gregdavill/ArcticKoala/hw/ArcticKoala-r0.1/plot/render_002.jpg

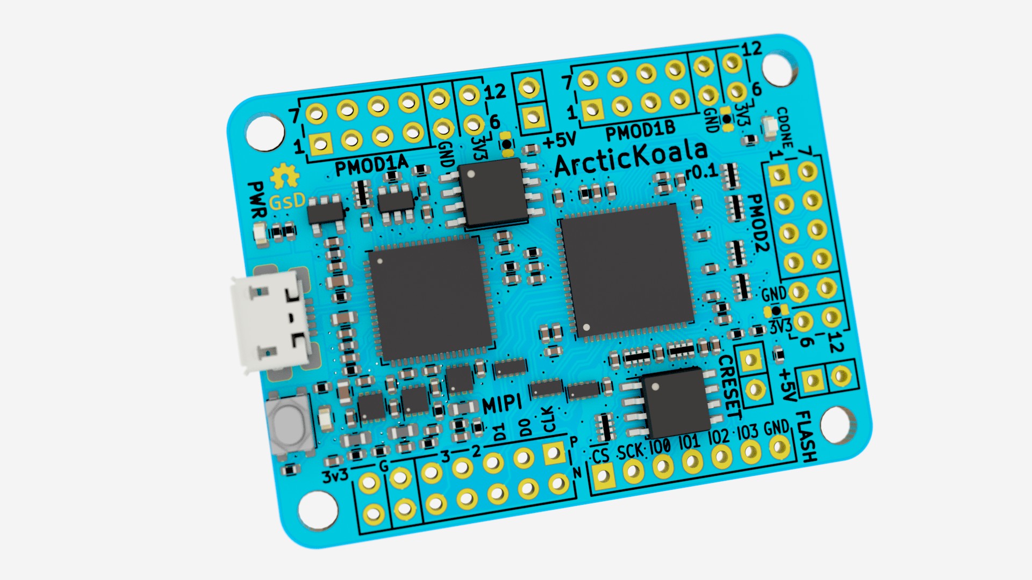
hw/ArcticKoala-r0.1/plot/render_002.jpg
