gregdavill/ArcticKoala/hw/ArcticKoala-r0.1/plot/arctic-koala-Back.png

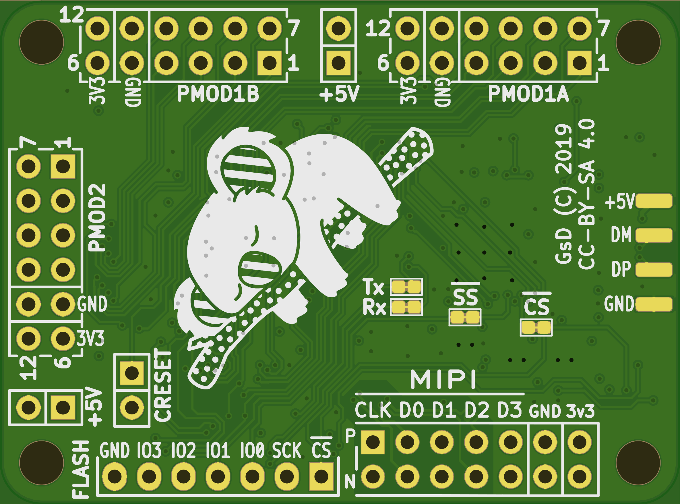
hw/ArcticKoala-r0.1/plot/arctic-koala-Back.png
