gregdavill/ArcticKoala/hw/ArcticKoala-r0.1/plot/arctic-koala-Front.png

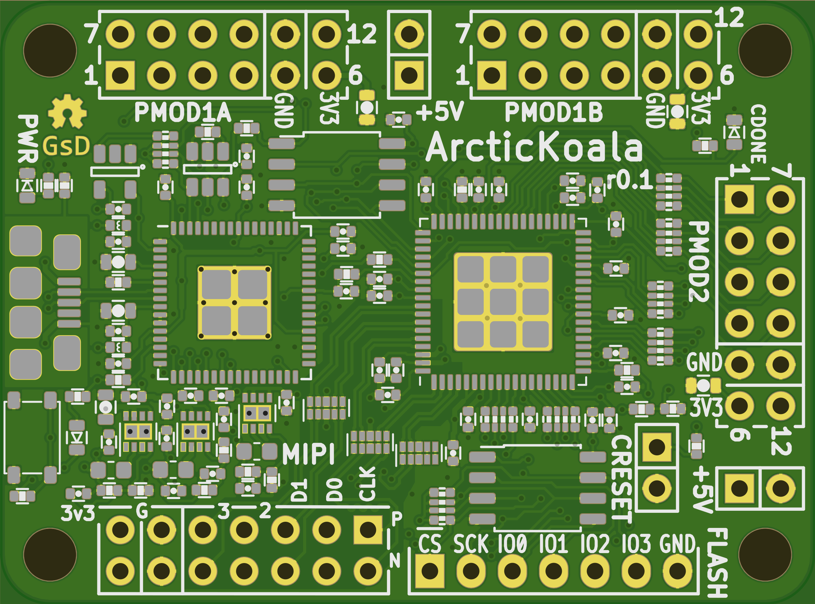
hw/ArcticKoala-r0.1/plot/arctic-koala-Front.png
