gregdavill/ArcticKoala/(threads)

Thread 1 (2019-12-13):

It needs more external memory

tommythorn, 2019-12-13:
It had to be said :)

gregdavill, 2019-12-15:
64Mbit isn't enough? :(

gregdavill, 2019-12-15:
Also, for what it's worth. The QFN72 package does not have the I/O resources to drive any form of DDR2/3/4 memory. That only appears to be available in the BGA packages.

tommythorn, 2019-12-15:
It’s your board, your rules.  I’m just here to speak up for the memory pigs.  Given the purpose of this board, SPI is probably ideal (way easier to use), but you are not going to drive video or run desktop Linux with this.

Closed 2019-12-15.

Thread 2 (2019-12-21):

PSRAM has wrong footprint

gregdavill, 2019-12-21:
PSRAM is available in standard SOIC8 packages, the hardware is populated with a Wide SOIC8 footprint.
The RAM still fits well enough.

Severity: minor.

Thread 3 (2019-12-21):

Red user LED is dim when FPGA is un-configured.

gregdavill, 2019-12-21:
- The FPGA applies a weak pull-up to all un-configured pins.
- The user LED is connected to a 1v8 I/O designed to be activated in an open-drain configuration.
- The Anode of the LED is connected to 3v3.

These design choices result in the LED activating from the ~1.5V that is applied across it and the current drawn from the weak-pull ups. Because LEDs are so efficient the LED appears around 50% brightness in this condition.

Thread 4 (2019-12-21):

FTDI contends the SPI bus with the FPGA

gregdavill, 2019-12-21:
While IDLE the FTDI appears to drive the bus reasonably hard. Enough to result in signals only making it to around 1/2 Vcc when driven by the FPGA. Because the FTDI is a second master connected to the FLASH for programming. This results in the configuration not being correctly loaded by the FPGA.

Adding 100R resistance inline to the following signals is enough to weaken the FTDIs grasp.
- SCK
- MISO
- MOSI
- CS

Thread 5 (2020-01-02):

Resistors on HighSpeed banks

gregdavill, 2020-01-02:
In-line resistors on high speed banks leading to the PMODs prohibit use of these pins for ~gigabit speed signals.

Solutions:
 - Add parallel inline capacitor as a high speed bypass. (May require downstream bias resistors depending on I/O standard)
 - Replace 33R with 0R
