gregdavill/ArcticKoala/hw/ArcticKoala-r0.1/arctic-koala.kicad_pcb

## KiCad design hw/ArcticKoala-r0.1/arctic-koala.kicad_pcb (2020-10-22)

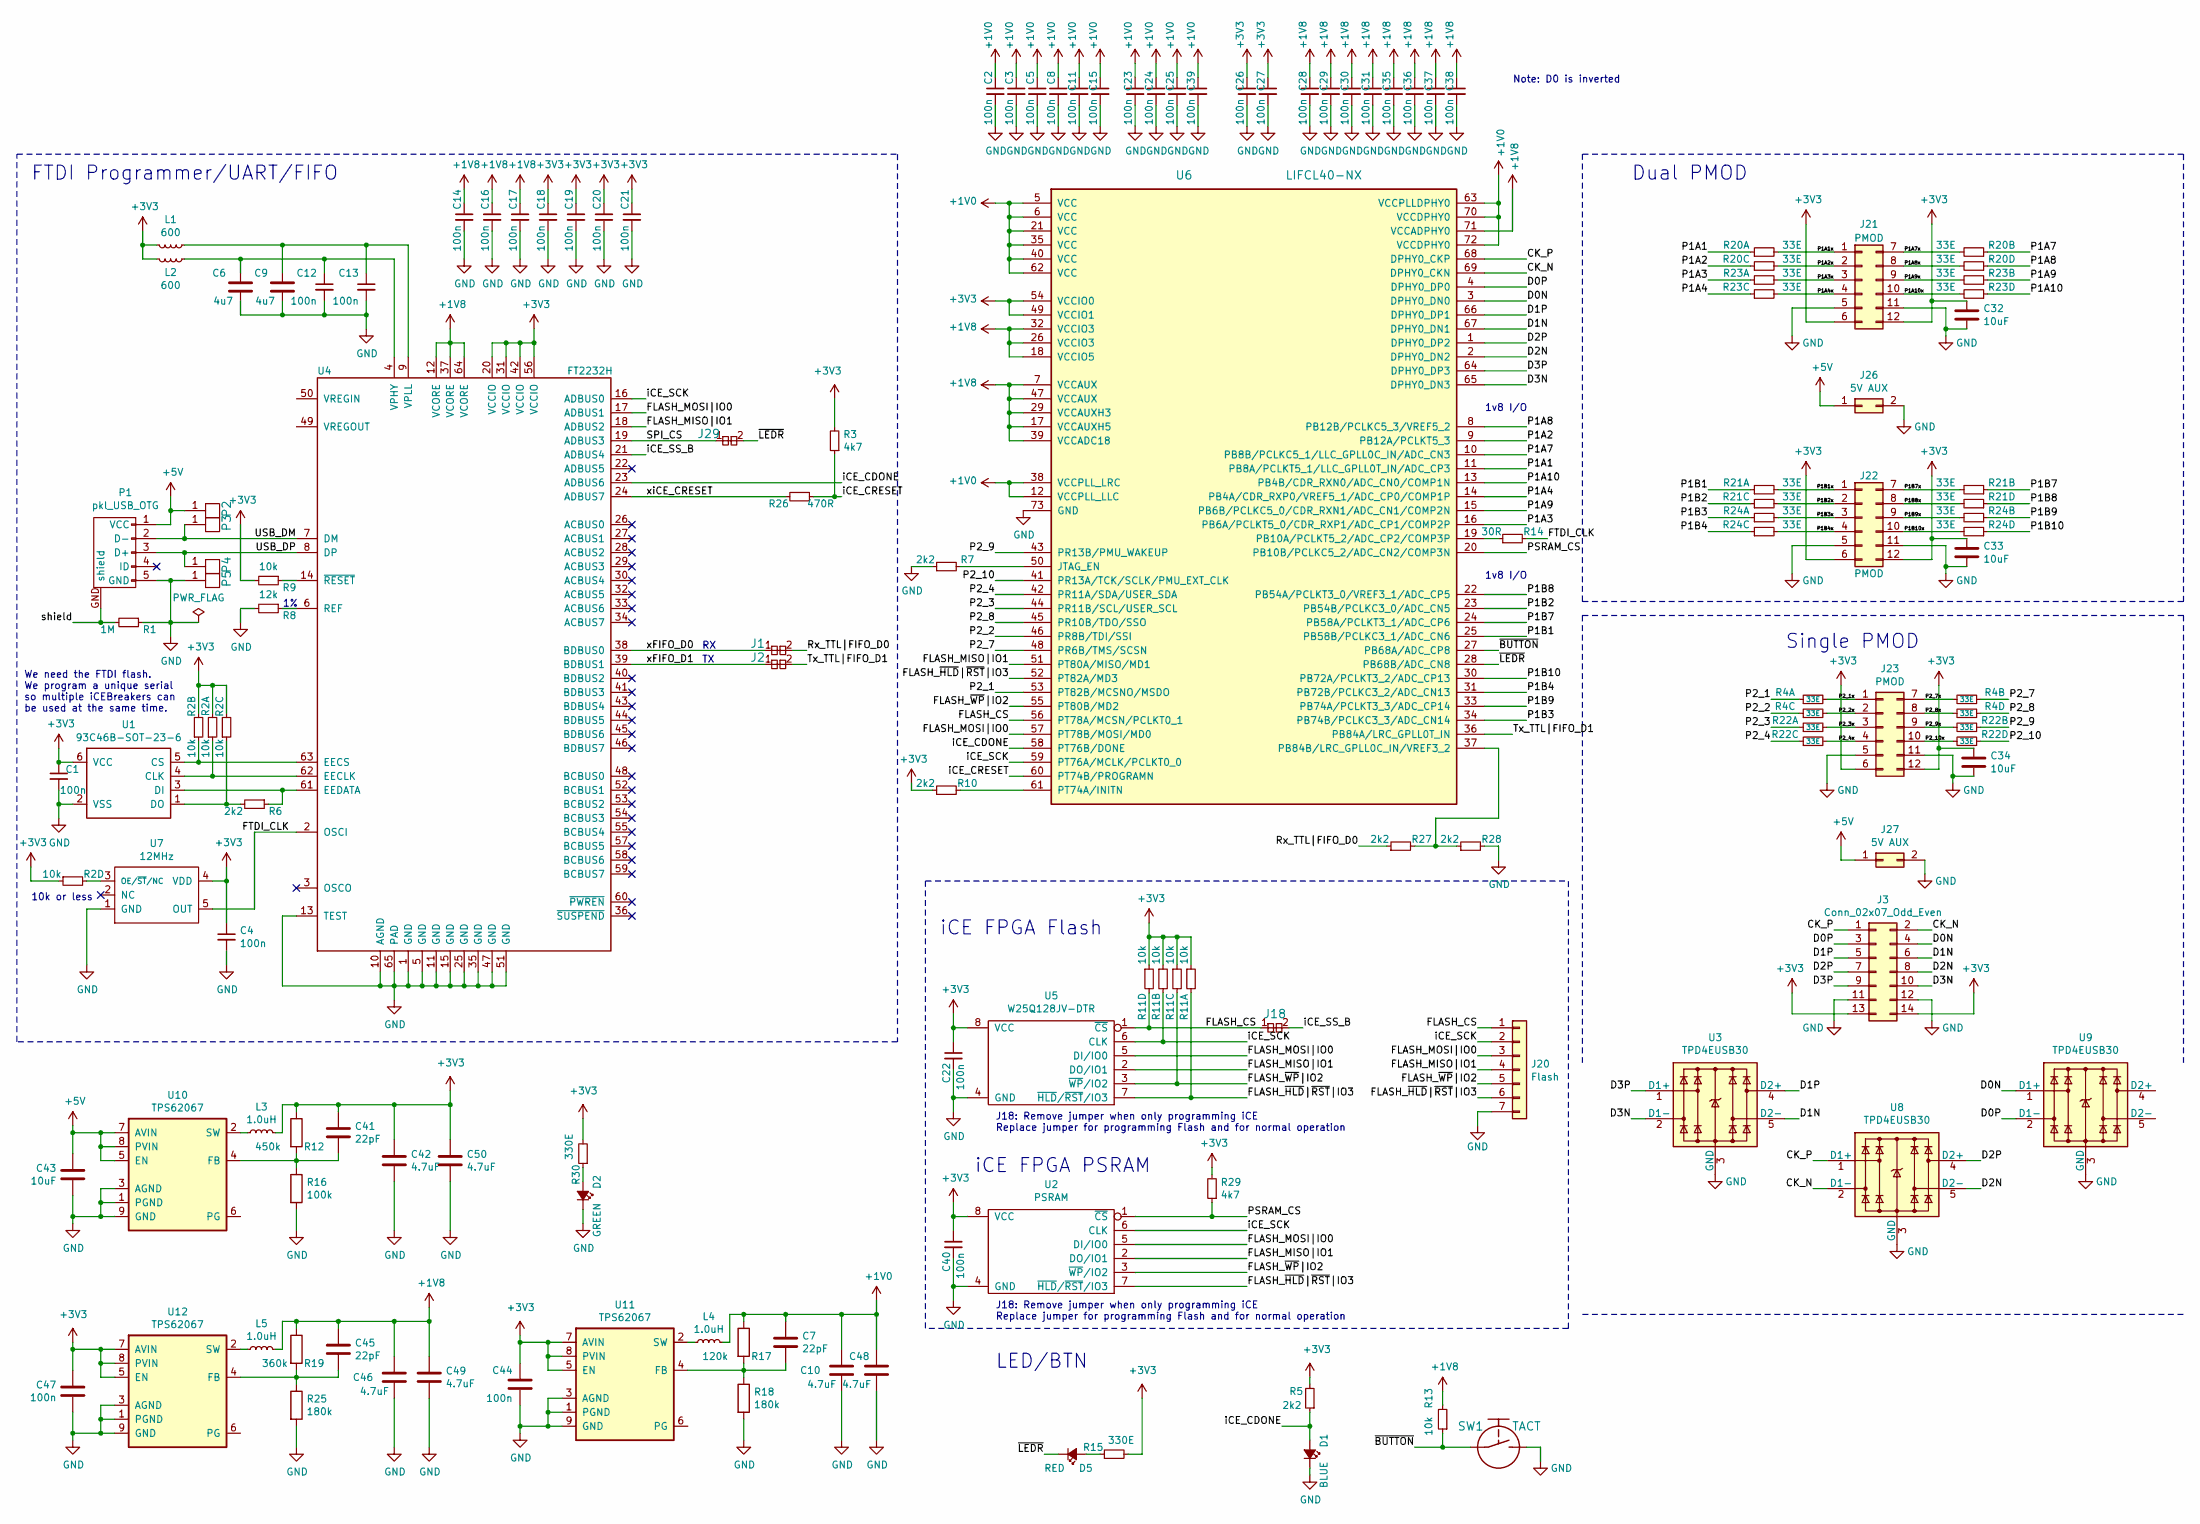
[picture p5: schematic arctic-koala.sch, ArcticKoala]

Parts:
C1, C2, C3, C4, C5, C8, C11, C12, C13, C14, C15, C16, C17, C18, C19, C20, C21, C22, C23, C24, C25, C26, C27, C28, C29, C30, C31, C35, C36, C37, C38, C39, C40, C44, C47: 100n; C_0402
C6, C9: 4u7; C_0603
C7, C41, C45: 22pF; C_0402
C10, C42, C46, C48, C49, C50: 4.7uF; C_0402
C32, C33, C34, C43: 10uF; C_0603
D1: BLUE; D_0603
D2: GREEN; D_0603
D5: RED; D_0603
J1, J2, J18, J29: Jumper; J_NC_0603_15
J3: Conn_02x07_Odd_Even; PinSocket_2x07_P2.54mm_Vertical
J20: Flash; Pin_Header_Straight_1x07
J21, J22, J23: PMOD; Socket_Strip_Angled_2x06
J26, J27: 5V AUX; Pin_Header_Straight_2x01
L1, L2: 600; L_0402
L3, L4, L5: 1.0uH; L_0603_1608Metric
P1: pkl_USB_OTG; Connector_USB_Micro_B_SMD
P2, P3, P4, P5: UP; PAD_SMD_1x2.65
R1: 1M; R_0402
R2, R11: 10k; R_Array_Convex_4x0402
R3, R29: 4k7; R_0402
R4, R20, R21, R22, R23, R24: 33E; R_Array_Convex_4x0402
R5, R6, R7, R10, R27, R28: 2k2; R_0402
R8: 12k; R_0402
R9, R13: 10k; R_0402
R12: 450k; R_0402
R14: 30R; R_0402
R15, R30: 330E; R_0402
R16: 100k; R_0402
R17: 120k; R_0402
R18, R25: 180k; R_0402
R19: 360k; R_0402
R26: 470R; R_0402
SW1: TACT; SW_SPST_3x4x2.5
U1: 93C46B-SOT-23-6; SOT-23-6
U2: PSRAM; SOIC-8_5.3x5.3mm_Pitch1.27mm
U3, U8, U9: TPD4EUSB30; USON-10_2.5x1.0mm_P0.5mm
U4: FT2232H; QFN-64-4.45mm1EP_9x9mm_Pitch0.5mm
U5: W25Q128JV-DTR; SOIC-8_5.3x5.3mm_Pitch1.27mm
U6: LIFCL40-NX; QFN-72-1EP_10x10mm_P0.5mm_EP6x6mm
U7: 12MHz; SOT-23-5
U10, U11, U12: TPS62067; WSON-8-1EP_2x2mm_P0.5mm_EP0.9x1.6mm_ThermalVias

Connections:
+1V0: C2.1, C3.1, C5.1, C7.1, C8.1, C10.1, C11.1, C15.1, C23.1, C24.1, C25.1, C39.1, C48.1, L4.2, R17.1, U6.5 (VCC), U6.6 (VCC), U6.12 (VCCPLL_LLC), U6.21 (VCC), U6.35 (VCC), U6.38 (VCCPLL_LRC), U6.40 (VCC), U6.62 (VCC), U6.63 (VCCPLLDPHY0), U6.70 (VCCDPHY0), U6.72 (VCCDPHY0)
+1V8: C14.1, C16.1, C17.1, C28.1, C29.1, C30.1, C31.1, C35.1, C36.1, C37.1, C38.1, C45.1, C46.1, C49.1, L5.2, R13.2, R19.1, U4.12 (VCORE), U4.37 (VCORE), U4.64 (VCORE), U6.7 (VCCAUX), U6.17 (VCCAUXH5), U6.18 (VCCIO5), U6.26 (VCCIO3), U6.29 (VCCAUXH3), U6.32 (VCCIO3), U6.39 (VCCADC18), U6.47 (VCCAUX), U6.71 (VCCADPHY0)
+3V3: C1.1, C4.1, C18.1, C19.1, C20.1, C21.1, C22.1, C26.1, C27.1, C32.2, C33.2, C34.2, C40.1, C41.1, C42.1, C44.1, C47.1, C50.1, J3.13, J3.14, J21.6, J21.12, J22.6, J22.12, J23.6, J23.12, L1.1, L2.1, L3.2, R2.2, R2.4, R2.6, R2.7, R3.2, R5.2, R9.2, R10.1, R11.1, R11.3, R11.5, R11.7, R12.1, R15.2, R29.2, R30.2, U1.6 (VCC), U2.8 (VCC), U4.20 (VCCIO), U4.31 (VCCIO), U4.42 (VCCIO), U4.56 (VCCIO), U5.8 (VCC), U6.49 (VCCIO1), U6.54 (VCCIO0), U7.4 (VDD), U11.5 (EN), U11.7 (AVIN), U11.8 (PVIN), U12.5 (EN), U12.7 (AVIN), U12.8 (PVIN)
+5V: C43.1, J26.1, J27.1, P1.1 (VCC), P2.1, U10.5 (EN), U10.7 (AVIN), U10.8 (PVIN)
/CK_N: J3.2, U6.69 (DPHY0_CKN), U8.2 (D1-)
/CK_P: J3.1, U6.68 (DPHY0_CKP), U8.1 (D1+)
/D0N: J3.4, U6.3 (DPHY0_DN0), U9.1 (D1+)
/D0P: J3.3, U6.4 (DPHY0_DP0), U9.2 (D1-)
/D1N: J3.6, U3.5 (D2-), U6.67 (DPHY0_DN1)
/D1P: J3.5, U3.4 (D2+), U6.66 (DPHY0_DP1)
/D2N: J3.8, U6.2 (DPHY0_DN2), U8.5 (D2-)
/D2P: J3.7, U6.1 (DPHY0_DP2), U8.4 (D2+)
/D3N: J3.10, U3.2 (D1-), U6.65 (DPHY0_DN3)
/D3P: J3.9, U3.1 (D1+), U6.64 (DPHY0_DP3)
/FLASH_CS: J18.1, J20.1, R11.8, U5.1 (~CS), U6.56 (PT78A/MCSN/PCLKT0_1)
/FLASH_MISO|IO1: J20.4, U2.2 (DO/IO1), U4.18 (ADBUS2), U5.2 (DO/IO1), U6.51 (PT80A/MISO/MD1)
/FLASH_MOSI|IO0: J20.3, U2.5 (DI/IO0), U4.17 (ADBUS1), U5.5 (DI/IO0), U6.57 (PT78B/MOSI/MD0)
/FLASH_~HLD~|~RST~|IO3: J20.6, R11.2, U2.7 (~HLD~/~RST~/IO3), U5.7 (~HLD~/~RST~/IO3), U6.52 (PT82A/MD3)
/FLASH_~WP~|IO2: J20.5, R11.6, U2.3 (~WP~/IO2), U5.3 (~WP~/IO2), U6.55 (PT80B/MD2)
/FTDI_CLK: R14.2, U4.2 (OSCI), U7.5 (OUT)
/P1A1: R20.1, U6.11 (PB8A/PCLKT5_1/LLC_GPLL0T_IN/ADC_CP3)
/P1A1x: J21.1, R20.2
/P1A2: R20.5, U6.9 (PB12A/PCLKT5_3)
/P1A2x: J21.2, R20.6
/P1A3: R23.1, U6.16 (PB6A/PCLKT5_0/CDR_RXP1/ADC_CP1/COMP2P)
/P1A3x: J21.3, R23.2
/P1A4: R23.5, U6.14 (PB4A/CDR_RXP0/VREF5_1/ADC_CP0/COMP1P)
/P1A4x: J21.4, R23.6
/P1A7: R20.3, U6.10 (PB8B/PCLKC5_1/LLC_GPLL0C_IN/ADC_CN3)
/P1A7x: J21.7, R20.4
/P1A8: R20.7, U6.8 (PB12B/PCLKC5_3/VREF5_2)
/P1A8x: J21.8, R20.8
/P1A9: R23.3, U6.15 (PB6B/PCLKC5_0/CDR_RXN1/ADC_CN1/COMP2N)
/P1A9x: J21.9, R23.4
/P1A10: R23.7, U6.13 (PB4B/CDR_RXN0/ADC_CN0/COMP1N)
/P1A10x: J21.10, R23.8
/P1B1: R21.1, U6.25 (PB58B/PCLKC3_1/ADC_CN6)
/P1B1x: J22.1, R21.2
/P1B2: R21.5, U6.23 (PB54B/PCLKC3_0/ADC_CN5)
/P1B2x: J22.2, R21.6
/P1B3: R24.1, U6.34 (PB74B/PCLKC3_3/ADC_CN14)
/P1B3x: J22.3, R24.2
/P1B4: R24.5, U6.31 (PB72B/PCLKC3_2/ADC_CN13)
/P1B4x: J22.4, R24.6
/P1B7: R21.3, U6.24 (PB58A/PCLKT3_1/ADC_CP6)
/P1B7x: J22.7, R21.4
/P1B8: R21.7, U6.22 (PB54A/PCLKT3_0/VREF3_1/ADC_CP5)
/P1B8x: J22.8, R21.8
/P1B9: R24.3, U6.33 (PB74A/PCLKT3_3/ADC_CP14)
/P1B9x: J22.9, R24.4
/P1B10: R24.7, U6.30 (PB72A/PCLKT3_2/ADC_CP13)
/P1B10x: J22.10, R24.8
/P2_1: R4.1, U6.53 (PT82B/MCSNO/MSDO)
/P2_1x: J23.1, R4.2
/P2_2: R4.5, U6.46 (PR8B/TDI/SSI)
/P2_2x: J23.2, R4.6
/P2_3: R22.1, U6.44 (PR11B/SCL/USER_SCL)
/P2_3x: J23.3, R22.2
/P2_4: R22.5, U6.42 (PR11A/SDA/USER_SDA)
/P2_4x: J23.4, R22.6
/P2_7: R4.3, U6.48 (PR6B/TMS/SCSN)
/P2_7x: J23.7, R4.4
/P2_8: R4.7, U6.45 (PR10B/TDO/SSO)
/P2_8x: J23.8, R4.8
/P2_9: R22.3, U6.43 (PR13B/PMU_WAKEUP)
/P2_9x: J23.9, R22.4
/P2_10: R22.7, U6.41 (PR13A/TCK/SCLK/PMU_EXT_CLK)
/P2_10x: J23.10, R22.8
/PSRAM_CS: R29.1, U2.1 (~CS), U6.20 (PB10B/PCLKC5_2/ADC_CN2/COMP3N)
/Rx_TTL|FIFO_D0: J1.2, R27.1
/SPI_CS: J29.1, U4.19 (ADBUS3)
/Tx_TTL|FIFO_D1: J2.2, U6.36 (PB84A/LRC_GPLL0T_IN)
/USB_DM: P1.2 (D-), P3.1, U4.7 (DM)
/USB_DP: P1.3 (D+), P4.1, U4.8 (DP)
/iCE_CDONE: D1.A, R5.1, U4.23 (ADBUS6), U6.58 (PT76B/DONE)
/iCE_CRESET: R3.1, R26.1, U6.60 (PT74B/PROGRAMN); also elsewhere on the board
/iCE_SCK: J20.2, R11.4, U2.6 (CLK), U4.16 (ADBUS0), U5.6 (CLK), U6.59 (PT76A/MCLK/PCLKT0_0)
/iCE_SS_B: J18.2, U4.21 (ADBUS4)
/shield: P1.GND (shield), R1.2
/xFIFO_D0: J1.1, U4.38 (BDBUS0)
/xFIFO_D1: J2.1, U4.39 (BDBUS1)
/xiCE_CRESET: R26.2, U4.24 (ADBUS7)
/~BUTTON: R13.1, SW1.1, U6.27 (PB68A/ADC_CP8)
/~LEDR: D5.C, J29.2, U6.28 (PB68B/ADC_CN8)
GND: C1.2, C2.2, C3.2, C4.2, C5.2, C6.2, C8.2, C9.2, C10.2, C11.2, C12.2, C13.2, C14.2, C15.2, C16.2, C17.2, C18.2, C19.2, C20.2, C21.2, C22.2, C23.2, C24.2, C25.2, C26.2, C27.2, C28.2, C29.2, C30.2, C31.2, C32.1, C33.1, C34.1, C35.2, C36.2, C37.2, C38.2, C39.2, C40.2, C42.2, C43.2, C44.2, C46.2, C47.2, C48.2, C49.2, C50.2, D1.C, D2.C, J3.11, J3.12, J20.7, J21.5, J21.11, J22.5, J22.11, J23.5, J23.11, J26.2, J27.2, P1.5 (GND), P5.1, R1.1, R7.1, R8.2, R16.2, R18.2, R25.2, R28.2, SW1.2, U1.2 (VSS), U2.4 (GND), U3.3 (GND), U3.8 (GND), U4.1 (GND), U4.5 (GND), U4.10 (AGND), U4.11 (GND), U4.13 (TEST), U4.15 (GND), U4.25 (GND), U4.35 (GND), U4.47 (GND), U4.51 (GND), U4.65 (PAD), U5.4 (GND), U6.73 (GND), U7.1 (GND), U8.3 (GND), U8.8 (GND), U9.3 (GND), U9.8 (GND), U10.1 (PGND), U10.3 (AGND), U10.9 (GND), U11.1 (PGND), U11.3 (AGND), U11.9 (GND), U12.1 (PGND), U12.3 (AGND), U12.9 (GND); also elsewhere on the board
unnamed: C7.2, R17.2, R18.1, U11.4 (FB)
unnamed: C6.1, C12.1, L2.2, U4.4 (VPHY)
unnamed: C9.1, C13.1, L1.2, U4.9 (VPLL)
unnamed: C41.2, R12.2, R16.1, U10.4 (FB)
unnamed: C45.2, R19.2, R25.1, U12.4 (FB)
unnamed: D2.A, R30.1
unnamed: D5.A, R15.1
unnamed: L3.1, U10.2 (SW)
unnamed: L4.1, U11.2 (SW)
unnamed: L5.1, U12.2 (SW)
unnamed: R2.1, U1.4 (CLK), U4.62 (EECLK)
unnamed: R2.3, U1.5 (CS), U4.63 (EECS)
unnamed: R2.5, R6.2, U1.1 (DO)
unnamed: R2.8, U7.3 (OE/~ST~/NC)
unnamed: R6.1, U1.3 (DI), U4.61 (EEDATA)
unnamed: R7.2, U6.50 (JTAG_EN)
unnamed: R8.1, U4.6 (REF)
unnamed: R9.1, U4.14 (~RESET)
unnamed: R10.2, U6.61 (PT74A/INITN)
unnamed: R14.1, U6.19 (PB10A/PCLKT5_2/ADC_CP2/COMP3P)
unnamed: R27.2, R28.1, U6.37 (PB84B/LRC_GPLL0C_IN/VREF3_2)

Notes on the sheet:
10k or less
FTDI Programmer/UART/FIFO
J18: Remove jumper when only programming iCE Replace jumper for programming Flash and for normal operation
iCE FPGA Flash
Dual PMOD
Single PMOD
LED/BTN
We need the FTDI flash. We program a unique serial so multiple iCEBreakers can be used at the same time.
1v8 I/O
Note: D0 is inverted
iCE FPGA PSRAM

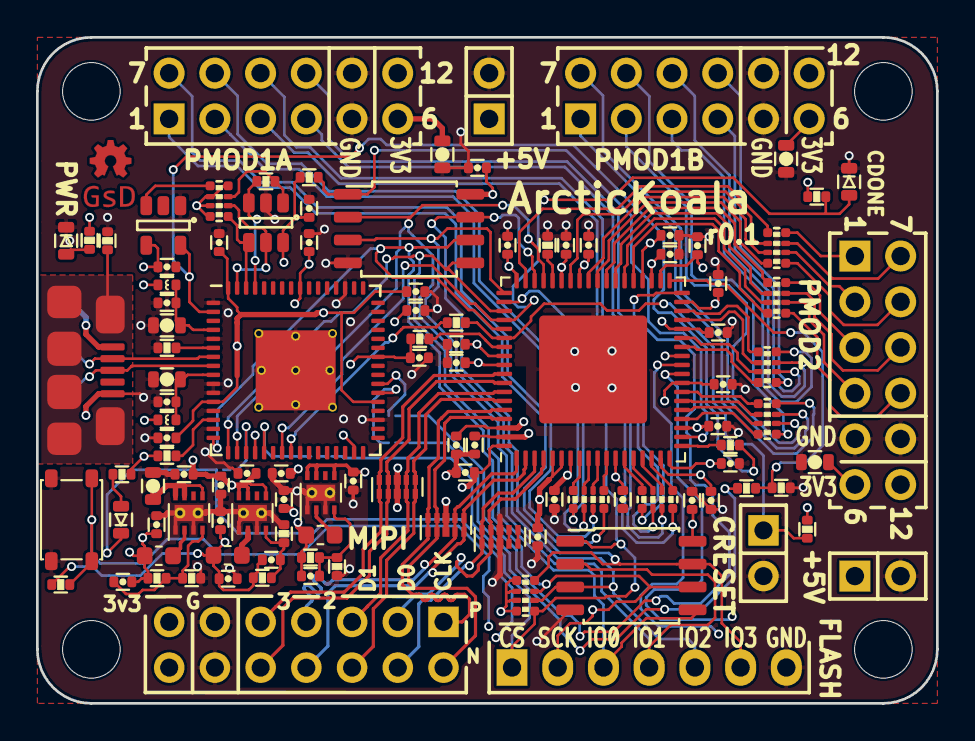
[picture p6: board arctic-koala.kicad_pcb from above]

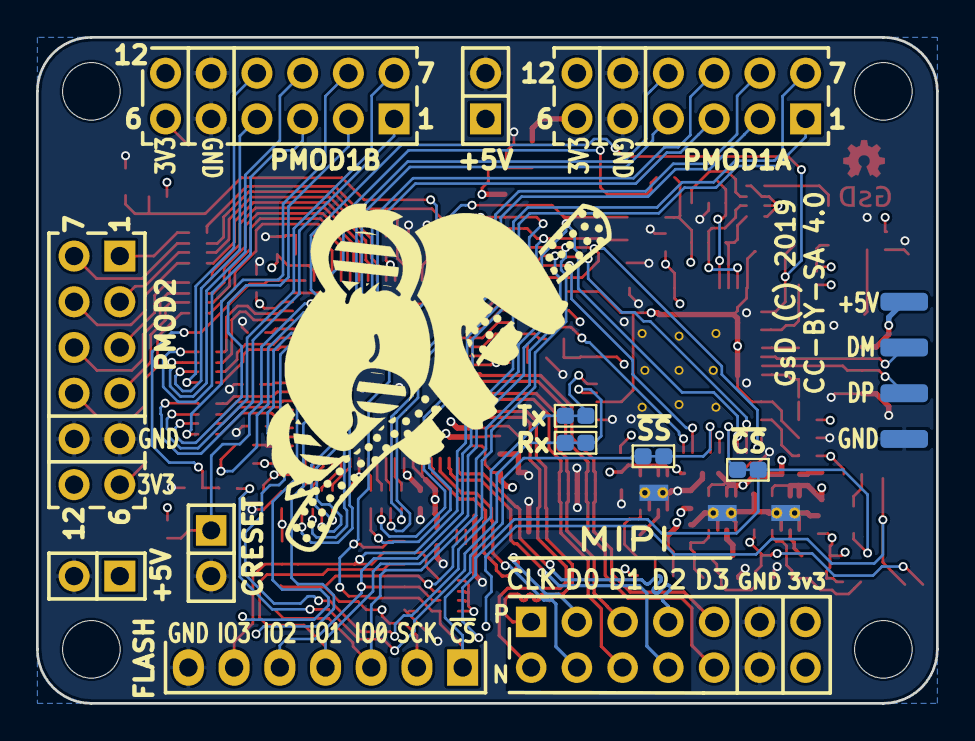
[picture p7: board arctic-koala.kicad_pcb from below]

Board: 4 copper layers, 50.0 x 37.0 mm, 118 parts (9 on the bottom side), 106 nets.

Other parts of the board:
J28: CRESET; PinHeader_2x01_P2.54mm_Vertical

Their connections:
/iCE_CRESET: J28.1; also elsewhere on the board
GND: J28.2; also elsewhere on the board
