gregdavill/ArcticKoala/(commit log)

2019-12-14 Updated KiCad files
    [arctic-koala.kicad_pcb, arctic-koala.sch]
2019-12-15 Added ESD protection to MIPI lines
    [arctic-koala.kicad_pcb, arctic-koala.sch]
2019-12-15 Completed hardware design files
    [arctic-koala.kicad_pcb, arctic-koala.sch]
2019-12-15 Added logo to PCB, cleaned up Silkscreen
    [arctic-koala.kicad_pcb]
2020-10-22 hw: Add Gerbers, BOM
    [arctic-koala.csv, arctic-koala.kicad_pcb, arctic-koala.sch]
