gregdavill/ArcticKoala/(notices)

Notices in the files:
hw/ArcticKoala-r0.1/arctic-koala.sch:
License: CC-BY-SA V4.0
hw/ArcticKoala-r0.1/arctic-koala.kicad_pcb:
(C) 2019 Greg Davill
License: CC-BY-SA 4.0
GsD (C) 2019
CC-BY-SA 4.0
